PiSCSI/piscsi-hw/README.md

# piscsi-hw
Hardware Repository for PiSCSI
