PiSCSI/piscsi-hw/ctrl_board_v1p6/PCA9554APW_118/PCA9554APW_118.step

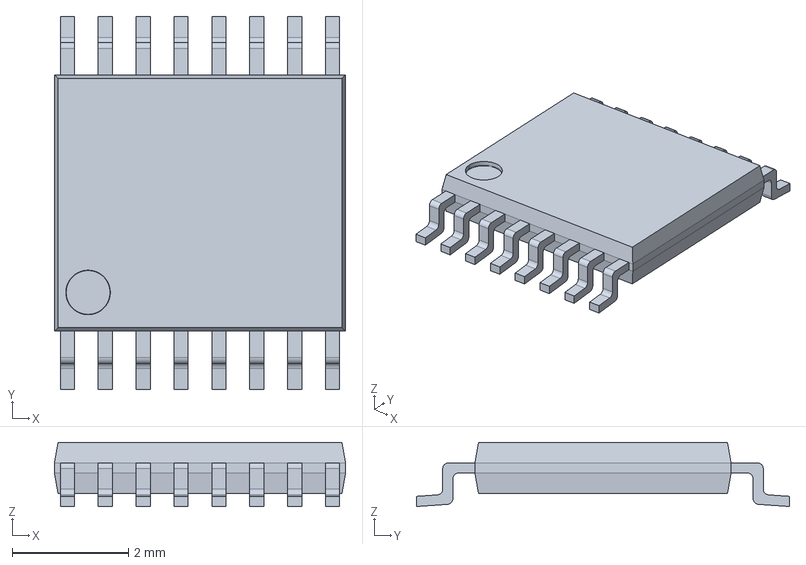
[picture p1: CAD file, 2022-11-30]
ctrl_board_v1p6/PCA9554APW_118/PCA9554APW_118.step
5.00 x 6.41 x 1.10 mm
