PiSCSI/piscsi-hw/IIciCase/IIciCase.FCStd

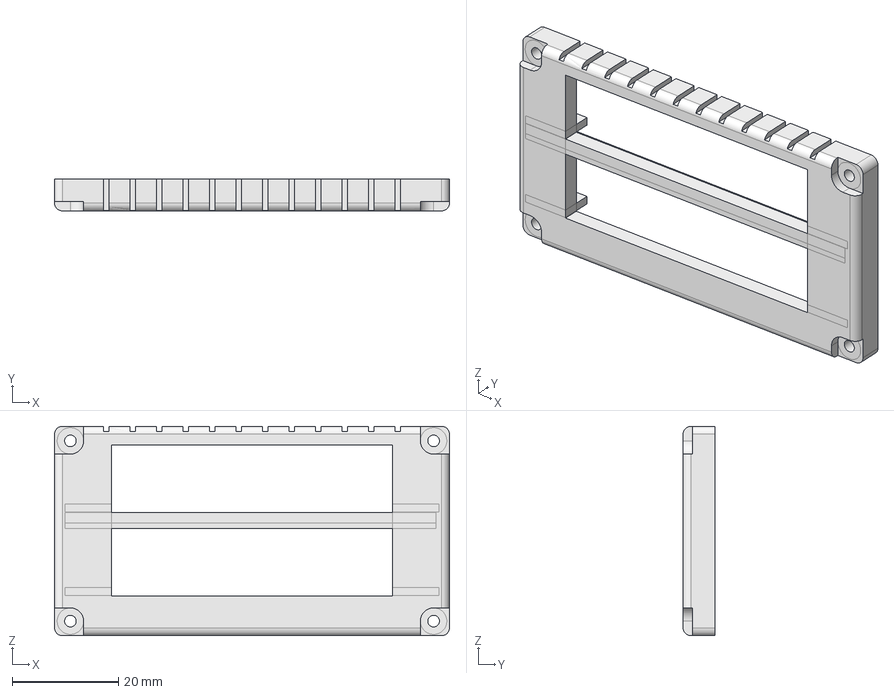
[picture p2: CAD file, 2022-11-30]
IIciCase/IIciCase.FCStd
74.5 x 6.00 x 39.5 mm
