PiSCSI/piscsi-hw/pb_bracket/powerbook_bracket.step

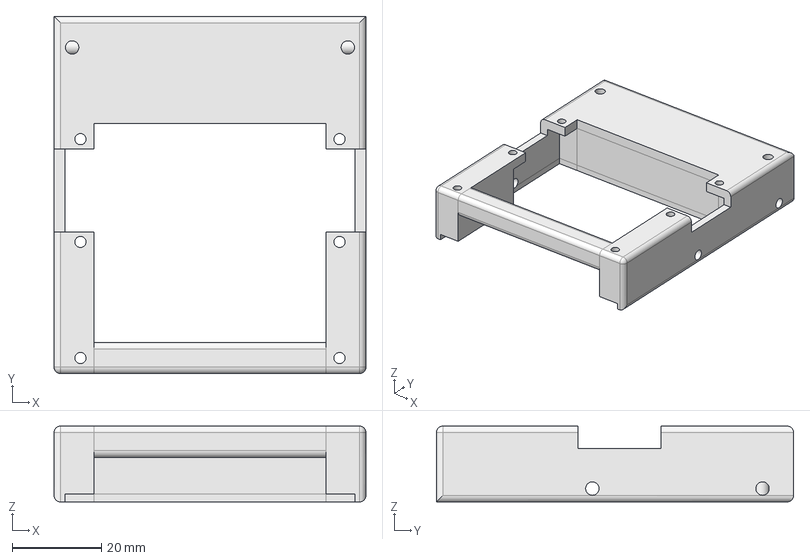
[picture p3: CAD file, 2022-11-30]
pb_bracket/powerbook_bracket.step
69.8 x 80.0 x 17.0 mm
