PiSCSI/piscsi-hw/piscsi_zero_1p1/TYPE-C-31-M-17/type-c-31-m-17.FCStd

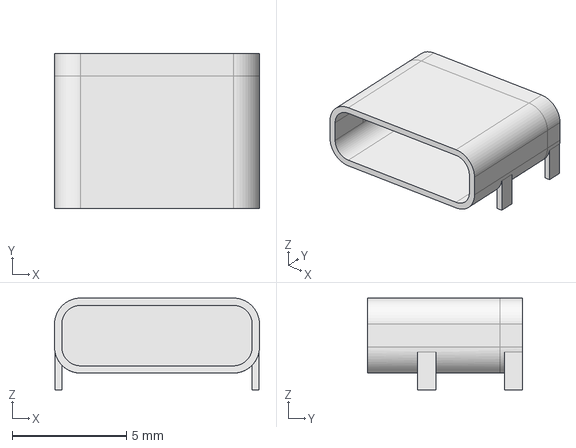
[picture p4: CAD file, 2022-11-30]
piscsi_zero_1p1/TYPE-C-31-M-17/type-c-31-m-17.FCStd
8.98 x 6.80 x 4.02 mm
