PiSCSI/piscsi-hw/rascsi_2p4/rascsi_2p4.step

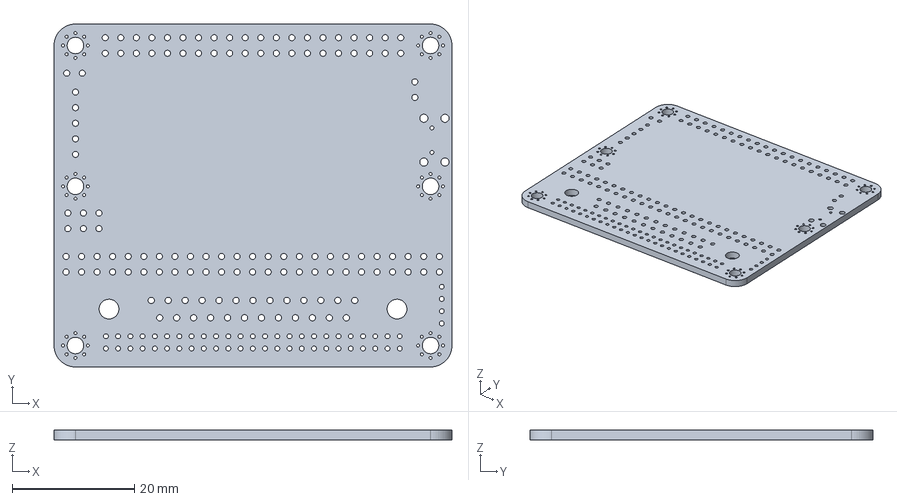
[picture p5: CAD file, 2022-11-30]
rascsi_2p4/rascsi_2p4.step
65.0 x 56.0 x 1.60 mm
