PiSCSI/piscsi-hw/rascsi_pogo_holder/rascsi_pogo_holder.FCStd

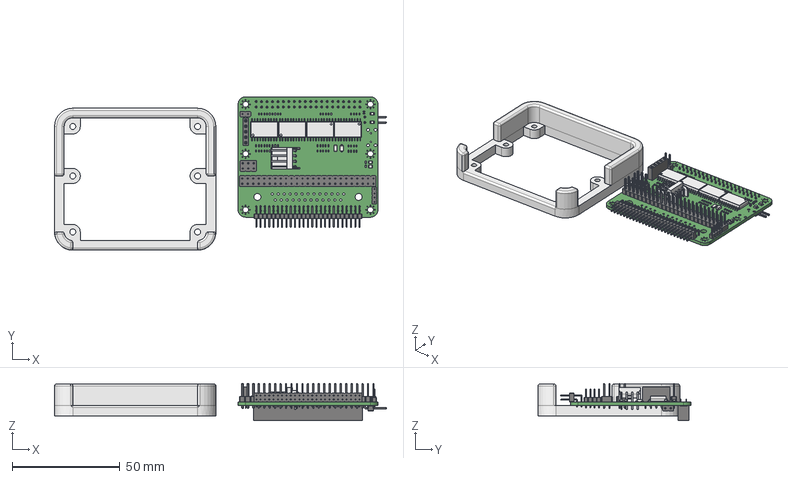
[picture p6: CAD file, 2022-11-30]
rascsi_pogo_holder/rascsi_pogo_holder.FCStd
154.3 x 71.3 x 17.2 mm
RaSCSI Holder
