PiSCSI/piscsi-hw/(list of files, cad)

Other CAD files:
rascsi_2p5/rascsi_2p5.step
piscsi_zero_1p1/TYPE-C-31-M-17/type-c-31-m-17-Body.step
pb_bracket/powerbook_bracket.FCStd
pb_bracket/powerbook_bracket.stl
rascsi_pogo_holder/rascsi_pogo_holder.stl
