PiSCSI/piscsi-hw/(threads)

Thread 7 (2024-04-23):

pizero 1.1 files are not correct in the JCLPCB section

Biker1bob, 2024-04-23:
The files cannot be produced @ JCLPCB.  Footprint of a couple of parts is not correct.

Also an accurate BOM and P&P file are not present.

Do it myself but I am not confident of my skills for that to post it up for all to use.
