PiSCSI/piscsi-hw/piscsi_zero_1p1/rascsi_zero_sch.pdf

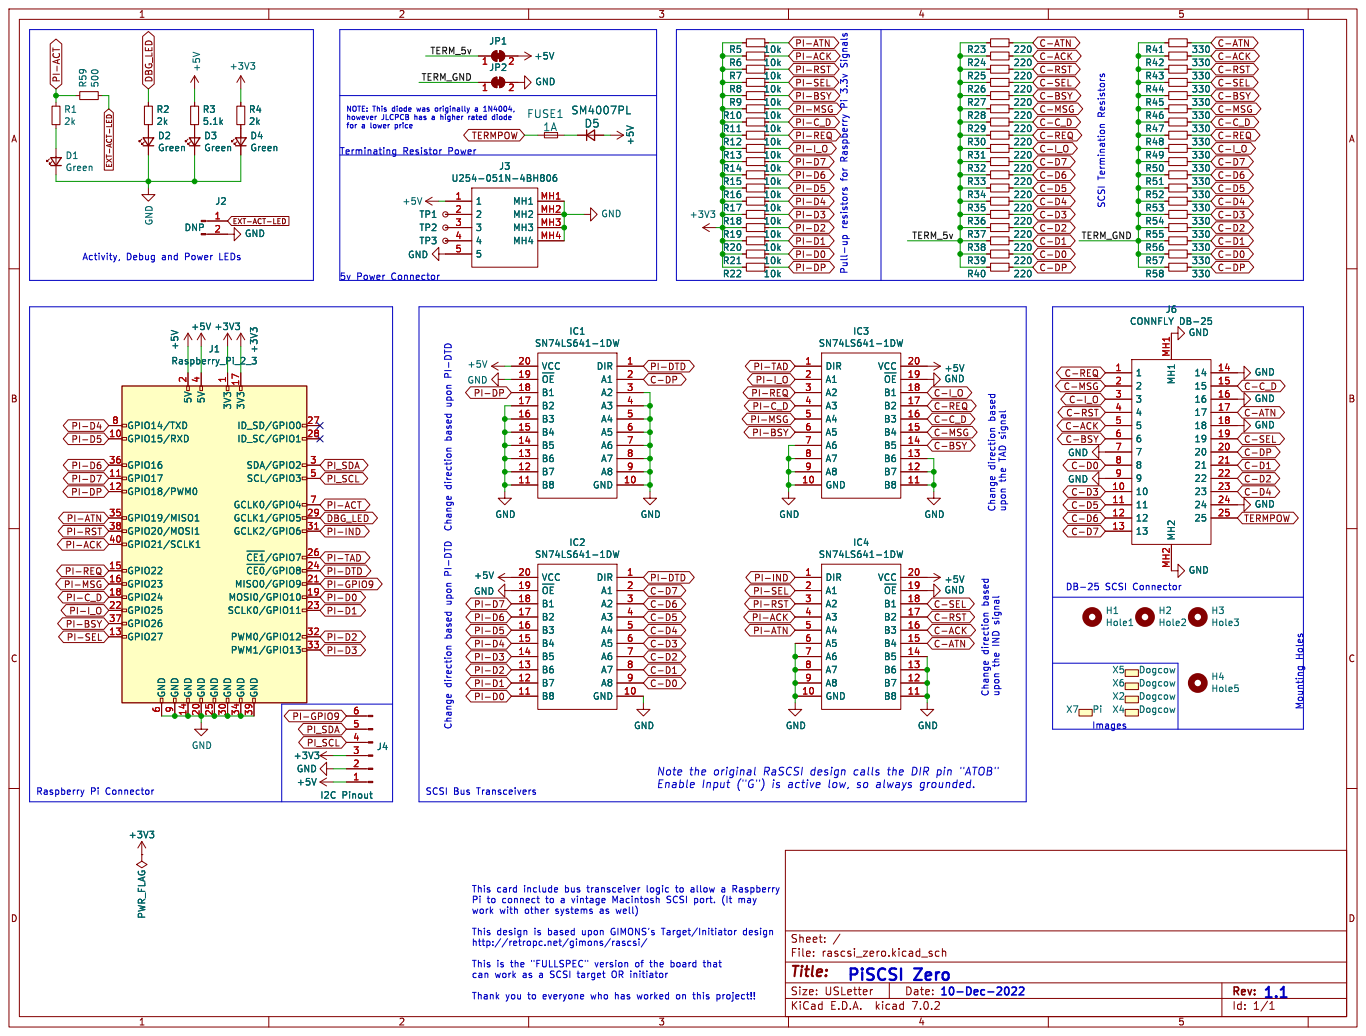
[picture p7: page 1]

C-ACK C-BSY C-D0 PI-D6 PI-D4 PI-D7 PI-D5 PI-D0 PI-D2 PI-D1 PI-D3 TERMPOW

PI-ATN
PI-SEL PI-ACK
PI-RST PI-BSY

C-SEL C-RST C-ACK PI-D2 PI-D1 PI-D3 PI-D0 PI-GPIO9 EXT-ACT-LED

EXT-ACT-LED PI-C_D

1 GPIO15/RXD 10 GPIO17 11 GPIO18/PWM0 12 GPIO27 13 GND 14 GPIO22 15 GPIO23 16 3V3 17 GPIO24 18 MOSI0/GPIO10 19 5V
PI-SEL PI-D7 PI-D4 PI-D5 PI-D6 PI-DP

PI-RST PI-ACK

Id: 1/1 Title: File: rascsi_zero.kicad_sch Sheet: /
