PiSCSI/piscsi-hw/piscsi_2p7/piscsi_sch.pdf

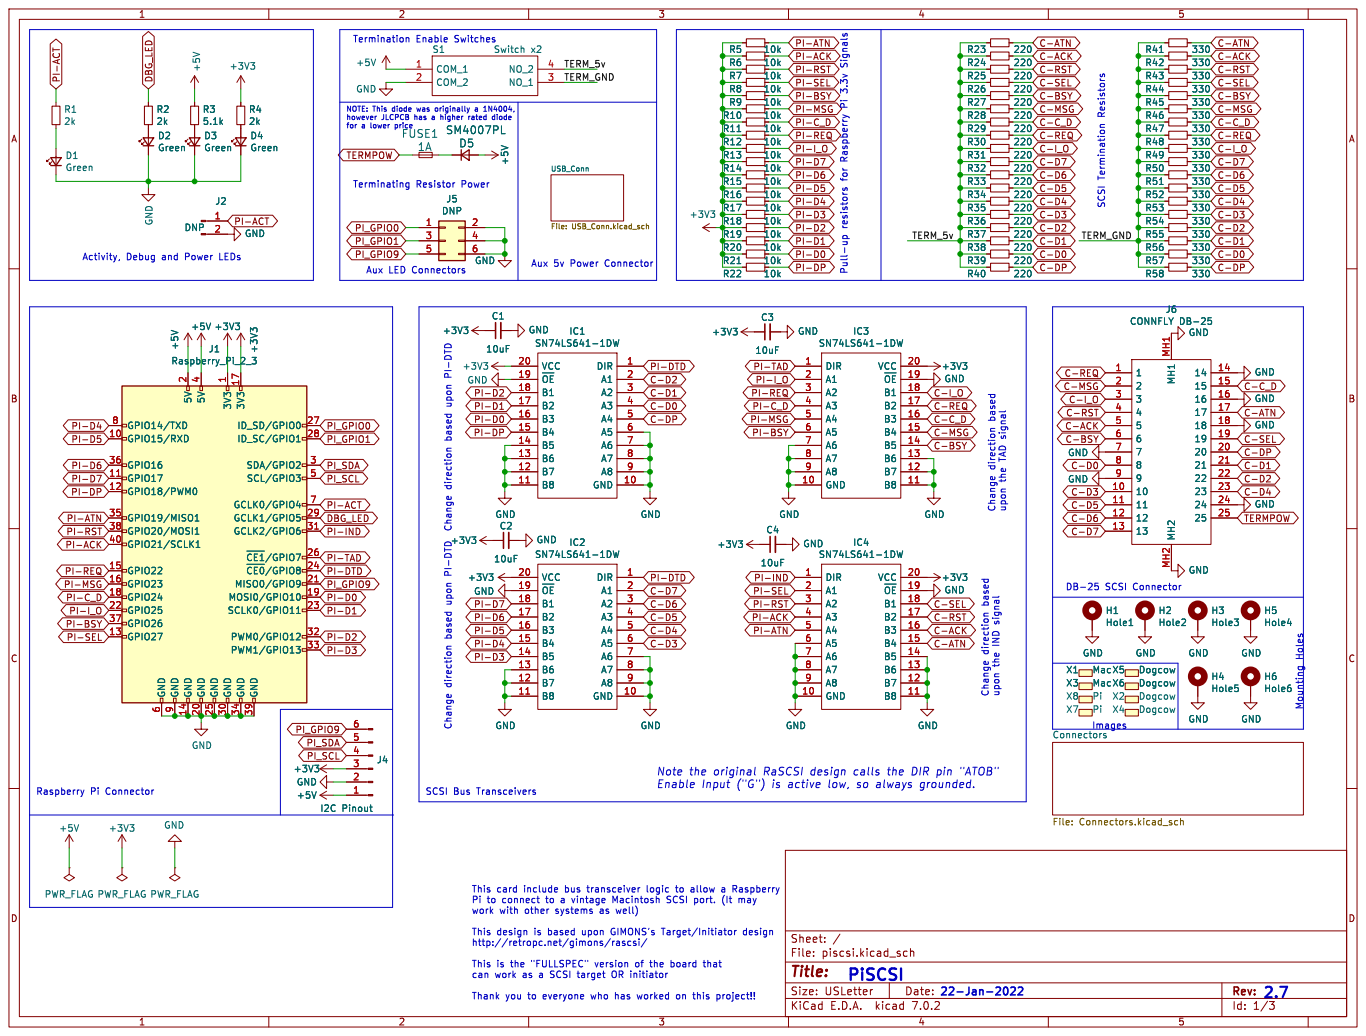
[picture p8: page 1]

PI-ACK
PI-RST PI-SEL PI-MSG
C-SEL PI-D3 PI-D7 PI-D1 PI-D0 PI-D2 PI-D5 PI-D4 PI-D6 PI-REQ

C-SEL PI-ACT PI-TAD

Aux LED ConnectorsChange direction based upon PI-DTD

Aux 5v Power Connector Change direction based upon PI-DTD
GND

PI-RST PI-REQ

PI-RST PI-IND
PI-SEL PI-ATN

E.D.A. kicad 7.0.2 Size: USLetter Rev: | D Date: KiCad

http://retropc.net/gimons/rascsi/ This is the "FULLSPEC" version of the board that can work as a SCSI target OR initiator Thank you to everyone who has worked on this project!!

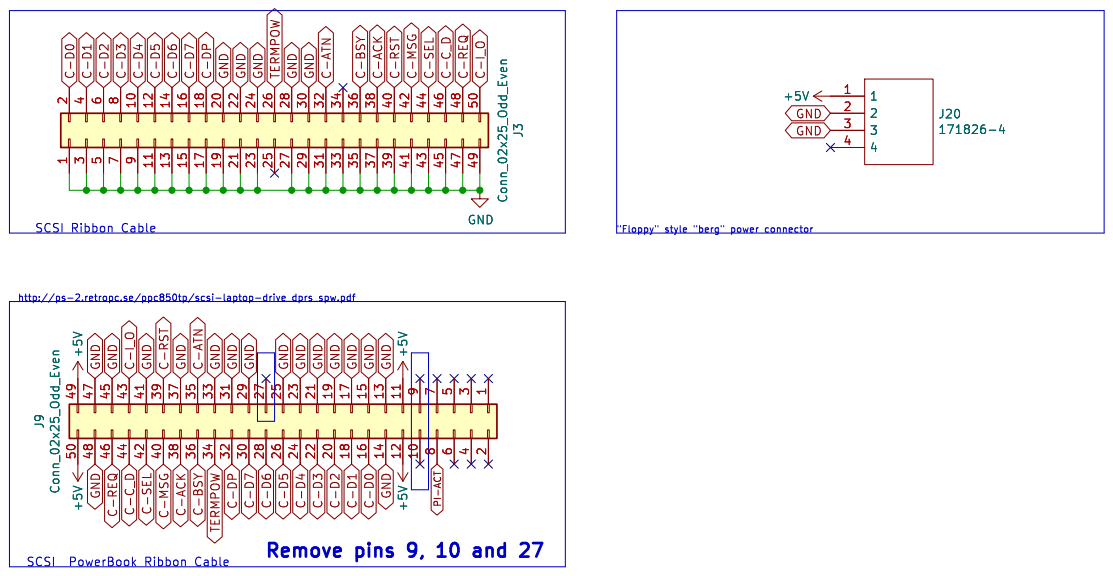
[picture p9: page 2]

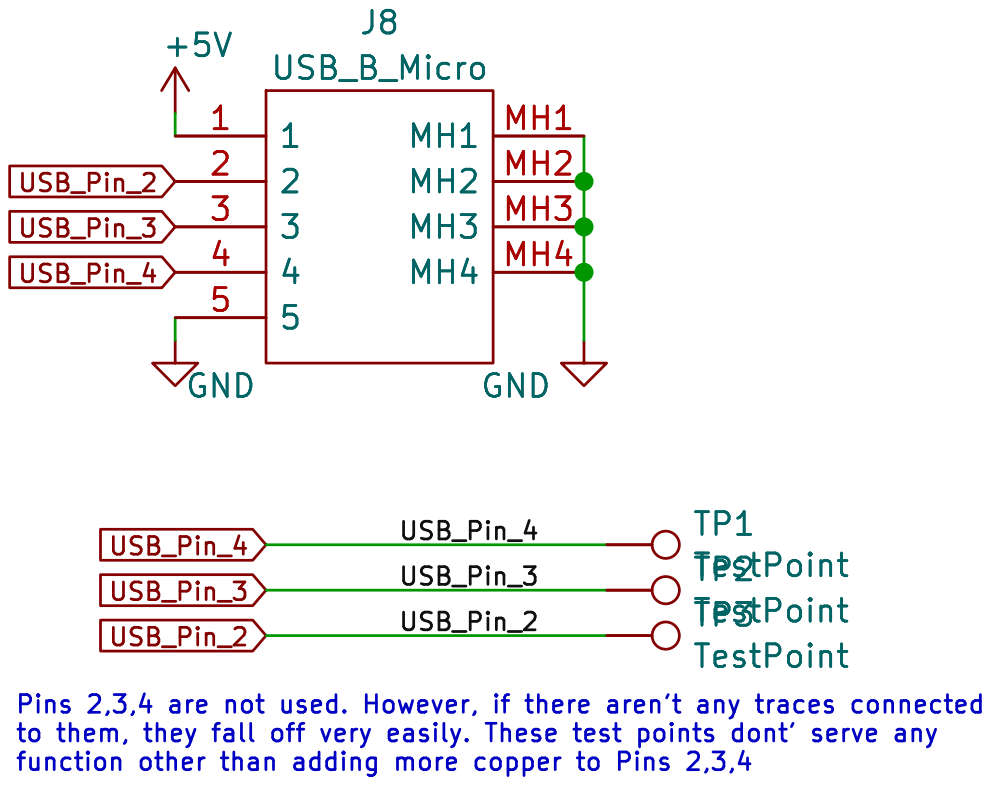
[picture p10: page 3]

to them, they fall off very easily. These test points dont' serve any

Id: 3/3 Title: File: USB_Conn.kicad_sch Sheet: /USB_Conn/
