PiSCSI/piscsi-hw/daisy_chain_board_v2/daisy_chain_board_sch.pdf

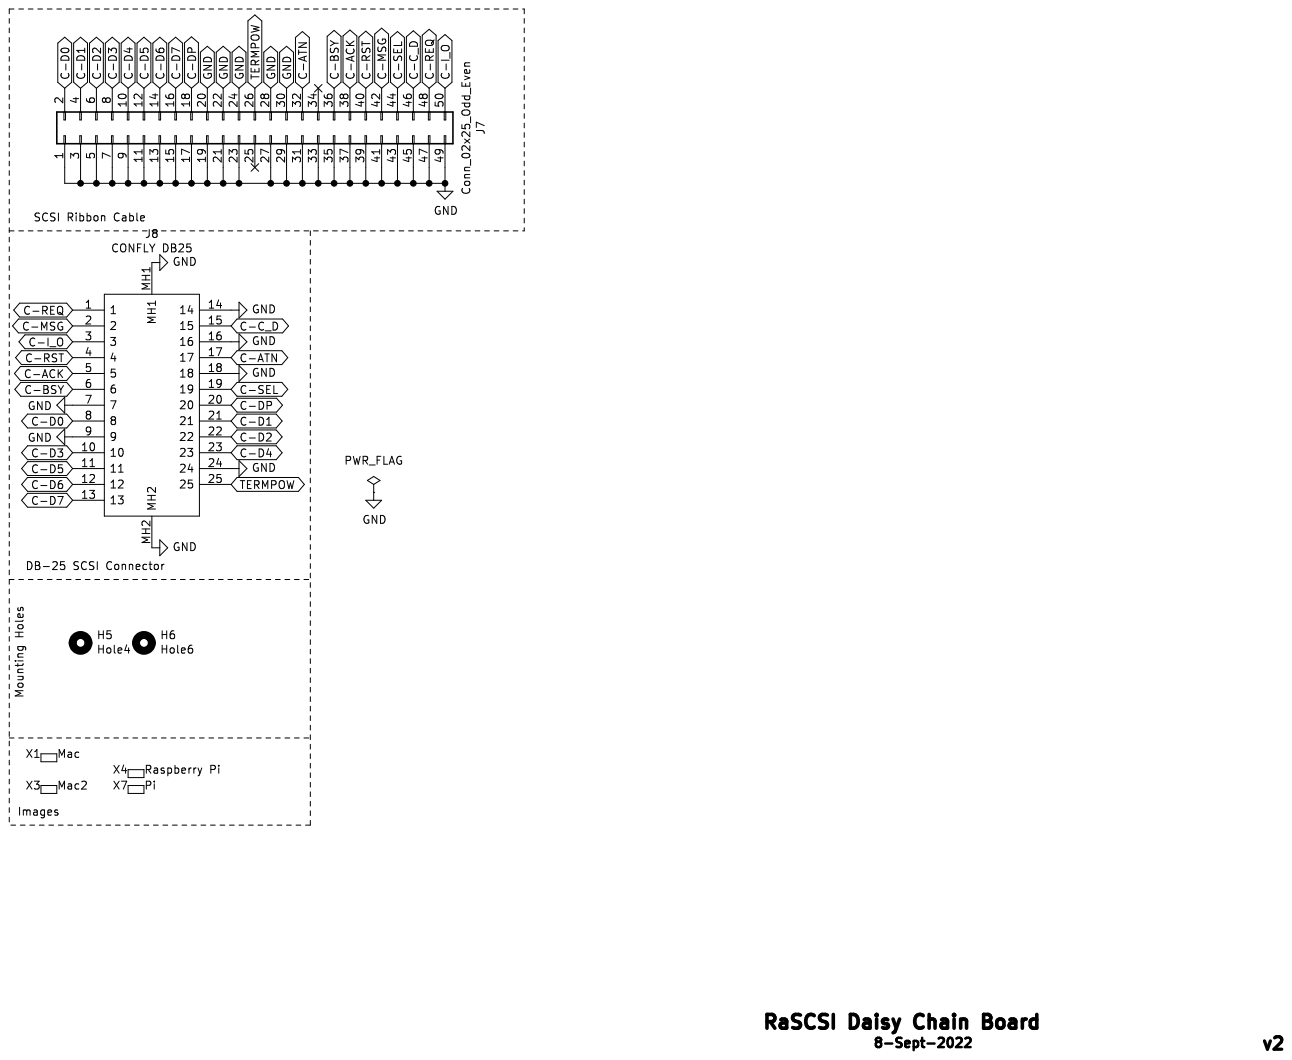
[picture p14: page 1]
