PiSCSI/piscsi-hw/rascsi_2p6/rascsi_2p6_sch.pdf

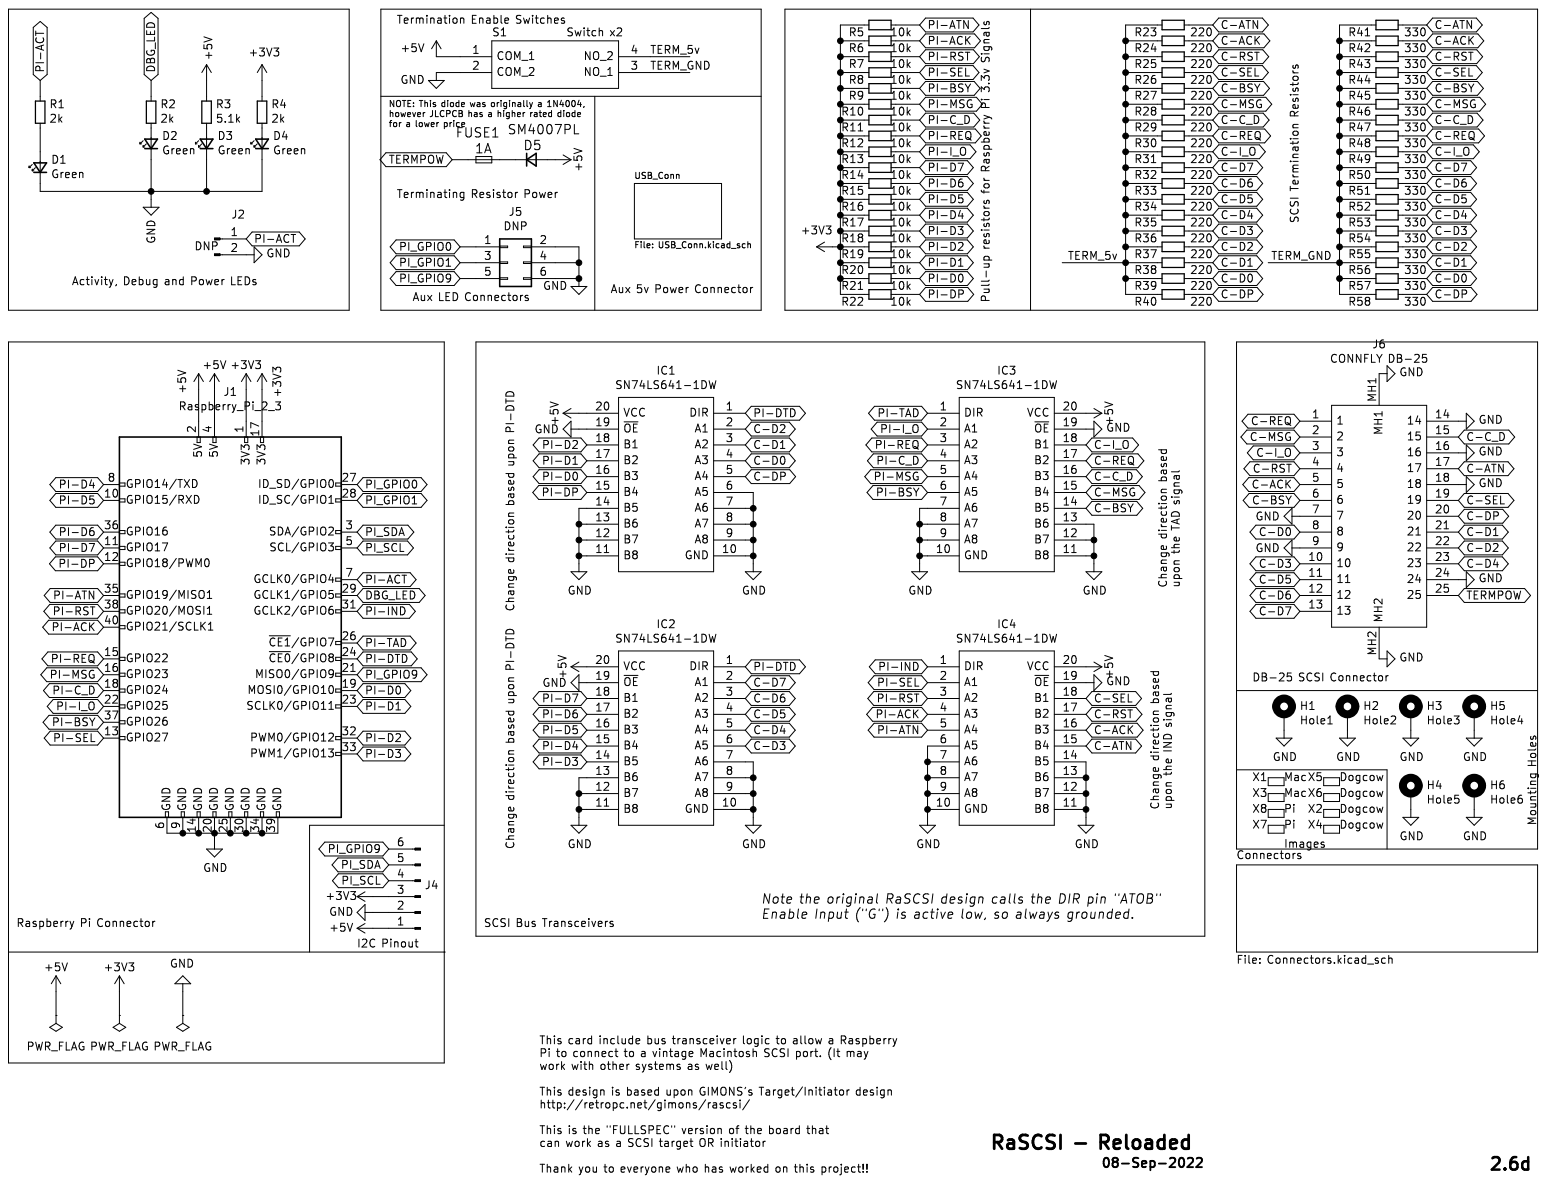
[picture p15: page 1]

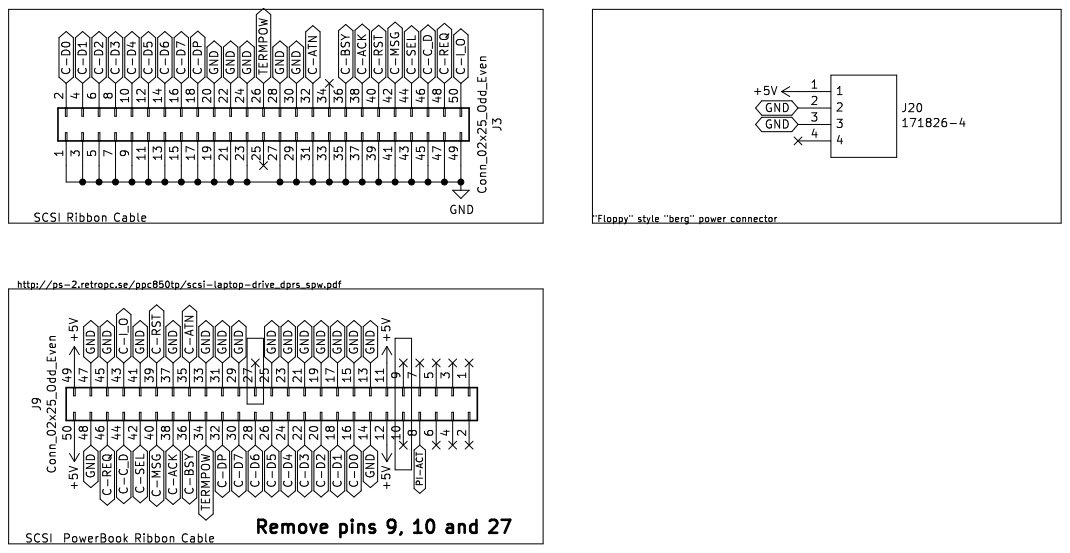
[picture p16: page 2]

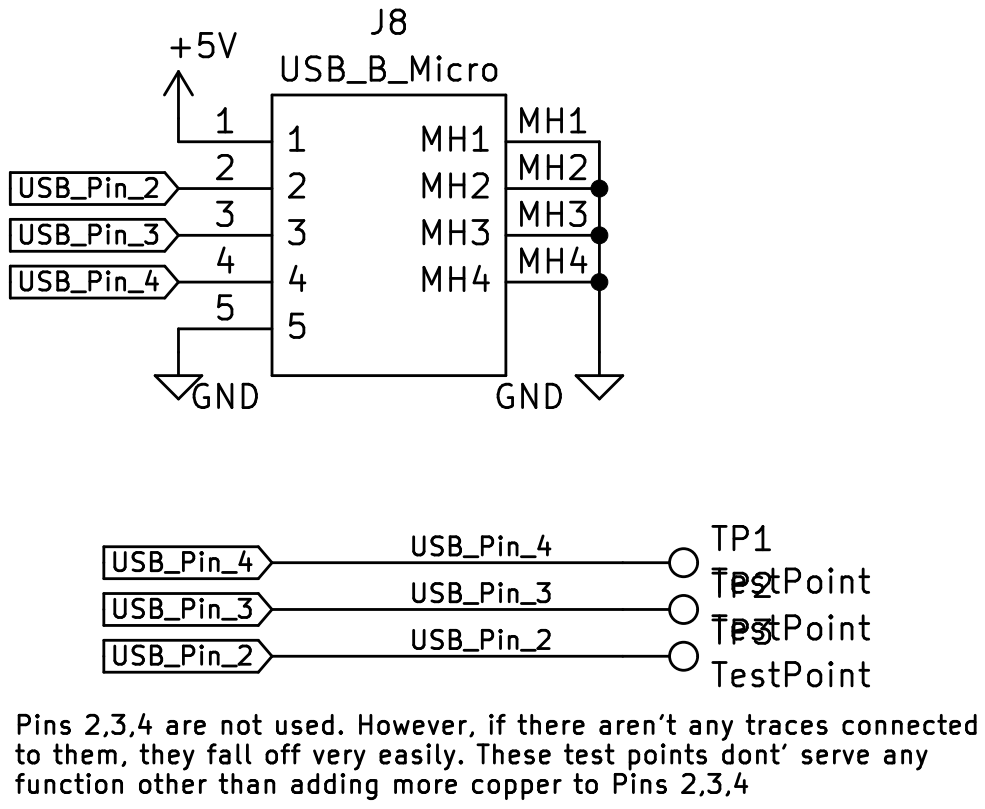
[picture p17: page 3]
