PiSCSI/piscsi-hw/piscsi_zero_1p1/rascsi_zero.kicad_pcb

## KiCad design piscsi_zero_1p1/rascsi_zero.kicad_pcb (2023-02-27)

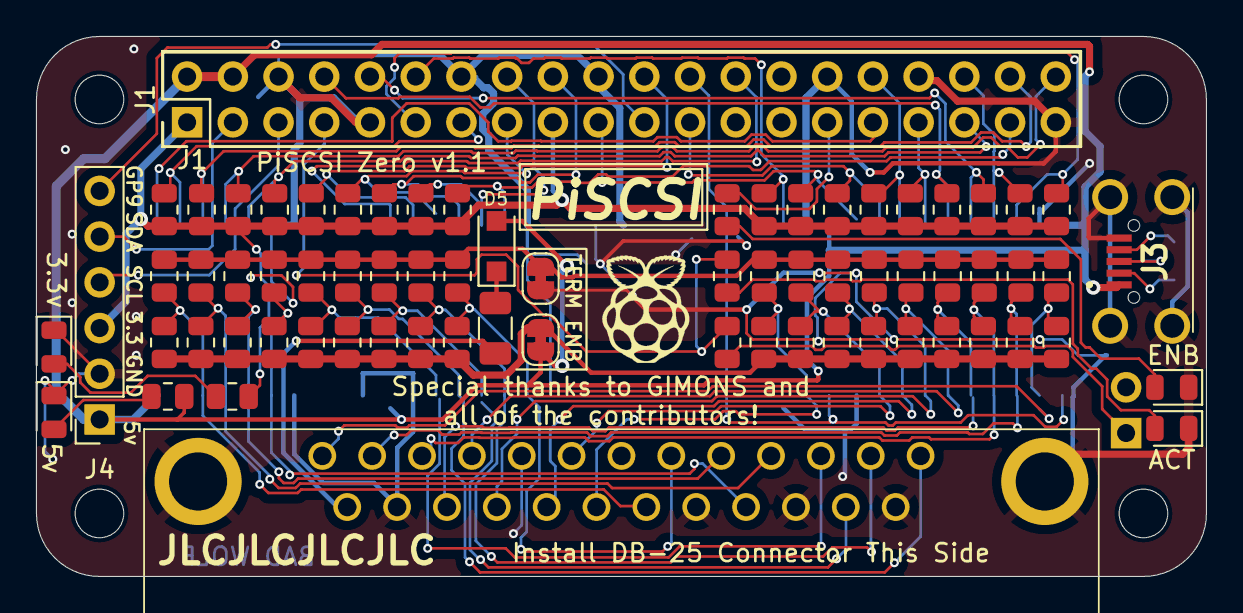
[picture p21: board rascsi_zero.kicad_pcb from above]

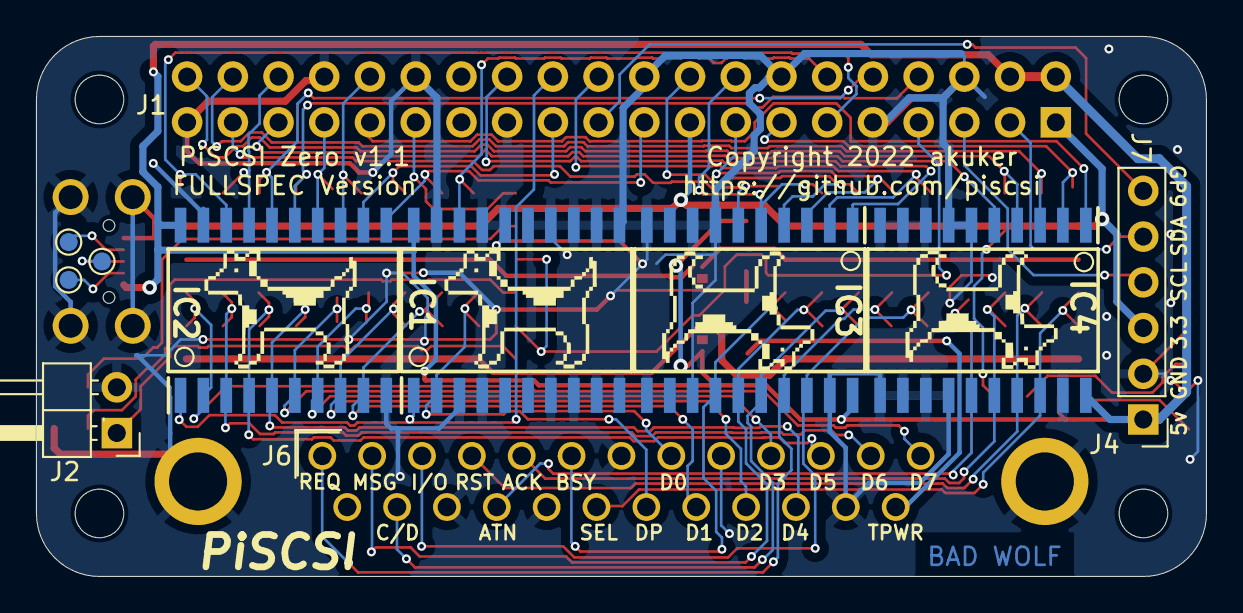
[picture p22: board rascsi_zero.kicad_pcb from below]

Board: 2 copper layers, 65.0 x 30.0 mm, 88 parts (13 on the bottom side), 59 nets.

Parts:
D1, D2, D3, D4: Green; LED_0805_2012Metric
D5: SM4007PL; D_SOD-123F
FUSE1: 1A; Fuse_1206_3216Metric
H1: Hole1; MountingHole_2.7mm_M2.5
H2: Hole2; MountingHole_2.7mm_M2.5
H3: Hole3; MountingHole_2.7mm_M2.5
H4: Hole5; MountingHole_2.7mm_M2.5
IC1, IC2, IC3, IC4: SN74LS641-1DW; SOIC127P1030X265-20N
J1: Raspberry_Pi_2_3; PinHeader_2x20_P2.54mm_Vertical
J2: DNP; PinHeader_1x02_P2.54mm_Horizontal
J3: U254-051N-4BH806; U254051N4BH806
J4: I2C Pinout; PinSocket_1x06_P2.54mm_Vertical
J6: CONNFLY DB-25; L717SDB25PA4CH4F
JP1, JP2: SolderJumper_2_Bridged; SolderJumper-2_P1.3mm_Bridged_RoundedPad1.0x1.5mm
R1, R2, R4: 2k; R_0805_2012Metric
R3: 5.1k; R_0805_2012Metric
R5, R6, R7, R8, R9, R10, R11, R12, R13, R14, R15, R16, R17, R18, R19, R20, R21, R22: 10k; R_0805_2012Metric
R23, R24, R25, R26, R27, R28, R29, R30, R31, R32, R33, R34, R35, R36, R37, R38, R39, R40: 220; R_0805_2012Metric
R41, R42, R43, R44, R45, R46, R47, R48, R49, R50, R51, R52, R53, R54, R55, R56, R57, R58: 330; R_0805_2012Metric
R59: 500; R_0805_2012Metric
TP1, TP2, TP3: TestPoint_Small; TestPoint_Pad_D1.0mm
X2, X4, X5, X6: Dogcow; dogcow
X7: Pi; pi_logo

Connections:
+3V3: J1.1 (3V3), J1.17 (3V3), J4.3, R4.1, R5.1, R6.1, R7.1, R8.1, R9.1, R10.1, R11.1, R12.1, R13.1, R14.1, R15.1, R16.1, R17.1, R18.1, R19.1, R20.1, R21.1, R22.1
+5V: D5.2 (A), IC1.20 (VCC), IC2.20 (VCC), IC3.20 (VCC), IC4.20 (VCC), J1.2 (5V), J1.4 (5V), J3.1, J4.1, JP1.2 (B), R3.1
/TERM_5v: JP1.1 (A), R23.1, R24.1, R25.1, R26.1, R27.1, R28.1, R29.1, R30.1, R31.1, R32.1, R33.1, R34.1, R35.1, R36.1, R37.1, R38.1, R39.1, R40.1
/TERM_GND: JP2.1 (A), R41.1, R42.1, R43.1, R44.1, R45.1, R46.1, R47.1, R48.1, R49.1, R50.1, R51.1, R52.1, R53.1, R54.1, R55.1, R56.1, R57.1, R58.1
C-ACK: IC4.16 (B3), J6.5, R24.2, R42.2
C-ATN: IC4.15 (B4), J6.17, R23.2, R41.2
C-BSY: IC3.14 (B5), J6.6, R27.2, R45.2
C-C_D: IC3.16 (B3), J6.15, R29.2, R47.2
C-D0: IC2.9 (A8), J6.8, R39.2, R57.2
C-D1: IC2.8 (A7), J6.21, R38.2, R56.2
C-D2: IC2.7 (A6), J6.22, R37.2, R55.2
C-D3: IC2.6 (A5), J6.10, R36.2, R54.2
C-D4: IC2.5 (A4), J6.23, R35.2, R53.2
C-D5: IC2.4 (A3), J6.11, R34.2, R52.2
C-D6: IC2.3 (A2), J6.12, R33.2, R51.2
C-D7: IC2.2 (A1), J6.13, R32.2, R50.2
C-DP: IC1.2 (A1), J6.20, R40.2, R58.2
C-I_O: IC3.18 (B1), J6.3, R31.2, R49.2
C-MSG: IC3.15 (B4), J6.2, R28.2, R46.2
C-REQ: IC3.17 (B2), J6.1, R30.2, R48.2
C-RST: IC4.17 (B2), J6.4, R25.2, R43.2
C-SEL: IC4.18 (B1), J6.19, R26.2, R44.2
DBG_LED: J1.29 (GCLK1/GPIO5), R2.1
EXT-ACT-LED: J2.1, R59.2
GND: D1.1 (K), D2.1 (K), D3.1 (K), D4.1 (K), IC1.3 (A2), IC1.4 (A3), IC1.5 (A4), IC1.6 (A5), IC1.7 (A6), IC1.8 (A7), IC1.9 (A8), IC1.10 (GND), IC1.11 (B8), IC1.12 (B7), IC1.13 (B6), IC1.14 (B5), IC1.15 (B4), IC1.16 (B3), IC1.17 (B2), IC1.19 (~OE), IC2.10 (GND), IC2.19 (~OE), IC3.7 (A6), IC3.8 (A7), IC3.9 (A8), IC3.10 (GND), IC3.11 (B8), IC3.12 (B7), IC3.13 (B6), IC3.19 (~OE), IC4.6 (A5), IC4.7 (A6), IC4.8 (A7), IC4.9 (A8), IC4.10 (GND), IC4.11 (B8), IC4.12 (B7), IC4.13 (B6), IC4.14 (B5), IC4.19 (~OE), J1.6 (GND), J1.9 (GND), J1.14 (GND), J1.20 (GND), J1.25 (GND), J1.30 (GND), J1.34 (GND), J1.39 (GND), J2.2, J3.5, J3.MH1, J3.MH2, J3.MH3, J3.MH4, J4.2, J6.7, J6.9, J6.14, J6.16, J6.18, J6.24, J6.MH1, J6.MH2, JP2.2 (B)
unnamed: D1.2 (A), R1.2
unnamed: D2.2 (A), R2.2
unnamed: D3.2 (A), R3.2
unnamed: D4.2 (A), R4.2
unnamed: D5.1 (K), FUSE1.1
unnamed: J3.2, TP1.1
unnamed: J3.3, TP2.1
unnamed: J3.4, TP3.1
PI-ACK: IC4.4 (A3), J1.40 (GPIO21/SCLK1), R6.2
PI-ACT: J1.7 (GCLK0/GPIO4), R1.1, R59.1
PI-ATN: IC4.5 (A4), J1.35 (GPIO19/MISO1), R5.2
PI-BSY: IC3.6 (A5), J1.37 (GPIO26), R9.2
PI-C_D: IC3.4 (A3), J1.18 (GPIO24), R11.2
PI-D0: IC2.11 (B8), J1.19 (MOSI0/GPIO10), R21.2
PI-D1: IC2.12 (B7), J1.23 (SCLK0/GPIO11), R20.2
PI-D2: IC2.13 (B6), J1.32 (PWM0/GPIO12), R19.2
PI-D3: IC2.14 (B5), J1.33 (PWM1/GPIO13), R18.2
PI-D4: IC2.15 (B4), J1.8 (GPIO14/TXD), R17.2
PI-D5: IC2.16 (B3), J1.10 (GPIO15/RXD), R16.2
PI-D6: IC2.17 (B2), J1.36 (GPIO16), R15.2
PI-D7: IC2.18 (B1), J1.11 (GPIO17), R14.2
PI-DP: IC1.18 (B1), J1.12 (GPIO18/PWM0), R22.2
PI-DTD: IC1.1 (DIR), IC2.1 (DIR), J1.24 (~CE0/GPIO8)
PI-GPIO9: J1.21 (MISO0/GPIO9), J4.6
PI-IND: IC4.1 (DIR), J1.31 (GCLK2/GPIO6)
PI-I_O: IC3.2 (A1), J1.22 (GPIO25), R13.2
PI-MSG: IC3.5 (A4), J1.16 (GPIO23), R10.2
PI-REQ: IC3.3 (A2), J1.15 (GPIO22), R12.2
PI-RST: IC4.3 (A2), J1.38 (GPIO20/MOSI1), R7.2
PI-SEL: IC4.2 (A1), J1.13 (GPIO27), R8.2
PI-TAD: IC3.1 (DIR), J1.26 (~CE1/GPIO7)
PI_SCL: J1.5 (SCL/GPIO3), J4.4
PI_SDA: J1.3 (SDA/GPIO2), J4.5
TERMPOW: FUSE1.2, J6.25
