PiSCSI/piscsi-hw/loopback_tester/loopback_tester.kicad_pcb

## KiCad design loopback_tester/loopback_tester.kicad_pcb (2022-11-30)

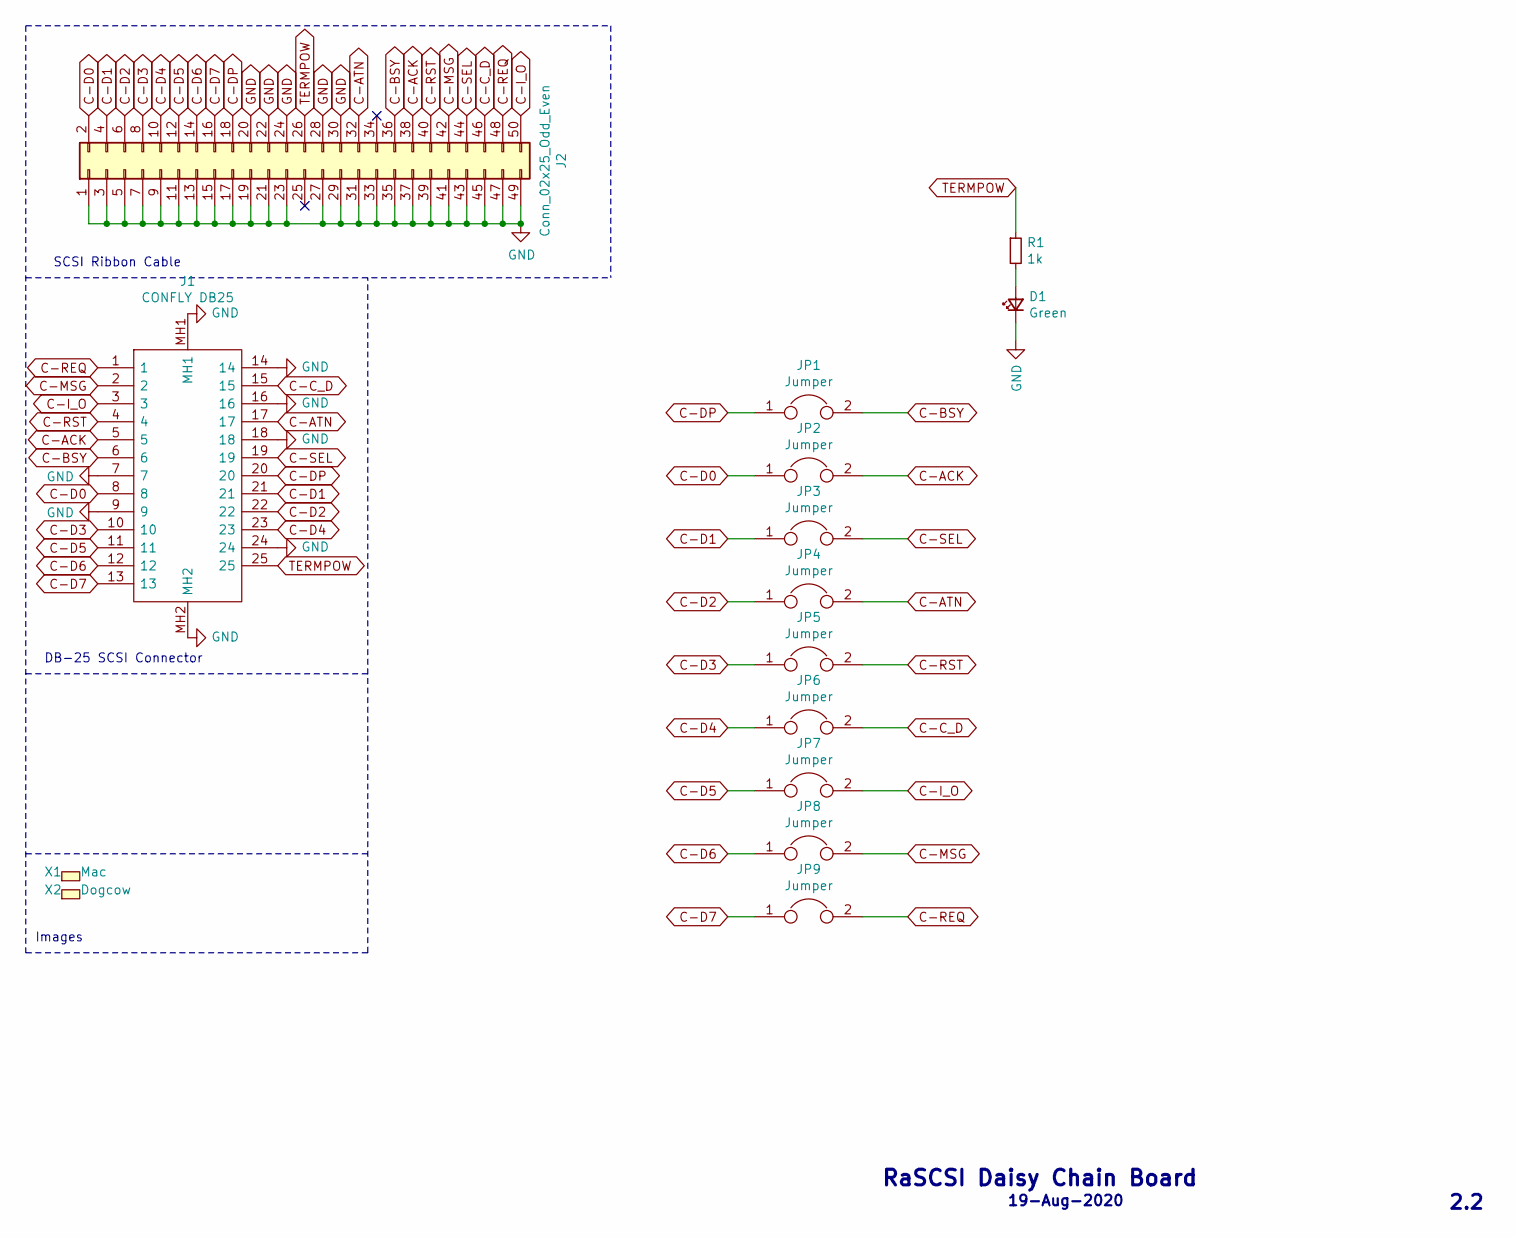
[picture p28: schematic loopback_tester.sch]

Parts:
D1: Green; LED_0805_2012Metric; LCSC C2297
J1: CONFLY DB25; L717SDB25PA4CH4F; Mouser Part Number 523-L717SDB25PA4CH4F
J2: Conn_02x25_Odd_Even; PinSocket_2x25_P2.54mm_Vertical; LCSC C40024
JP1, JP2, JP3, JP4, JP5, JP6, JP7, JP8, JP9: Jumper; SolderJumper-2_P1.3mm_Bridged_RoundedPad1.0x1.5mm
R1: 1k; R_0805_2012Metric; LCSC C17513
X1: Mac; mac_happy_small
X2: Dogcow; dogcow

Connections:
C-ACK: J1.5, J2.38, JP2.2
C-ATN: J1.17, J2.32, JP4.2
C-BSY: J1.6, J2.36, JP1.2
C-C_D: J1.15, J2.46, JP6.2
C-D0: J1.8, J2.2, JP2.1
C-D1: J1.21, J2.4, JP3.1
C-D2: J1.22, J2.6, JP4.1
C-D3: J1.10, J2.8, JP5.1
C-D4: J1.23, J2.10, JP6.1
C-D5: J1.11, J2.12, JP7.1
C-D6: J1.12, J2.14, JP8.1
C-D7: J1.13, J2.16, JP9.1
C-DP: J1.20, J2.18, JP1.1
C-I_O: J1.3, J2.50, JP7.2
C-MSG: J1.2, J2.42, JP8.2
C-REQ: J1.1, J2.48, JP9.2
C-RST: J1.4, J2.40, JP5.2
C-SEL: J1.19, J2.44, JP3.2
GND: D1.1 (K), J1.7, J1.9, J1.14, J1.16, J1.18, J1.24, J1.MH1, J1.MH2, J2.1, J2.3, J2.5, J2.7, J2.9, J2.11, J2.13, J2.15, J2.17, J2.19, J2.20, J2.21, J2.22, J2.23, J2.24, J2.27, J2.28, J2.29, J2.30, J2.31, J2.33, J2.35, J2.37, J2.39, J2.41, J2.43, J2.45, J2.47, J2.49
unnamed: D1.2 (A), R1.2
TERMPOW: J1.25, J2.26, R1.1

Notes on the sheet:
DB-25 SCSI Connector
SCSI Ribbon Cable
Images
RaSCSI Daisy Chain Board
2.2
19-Aug-2020

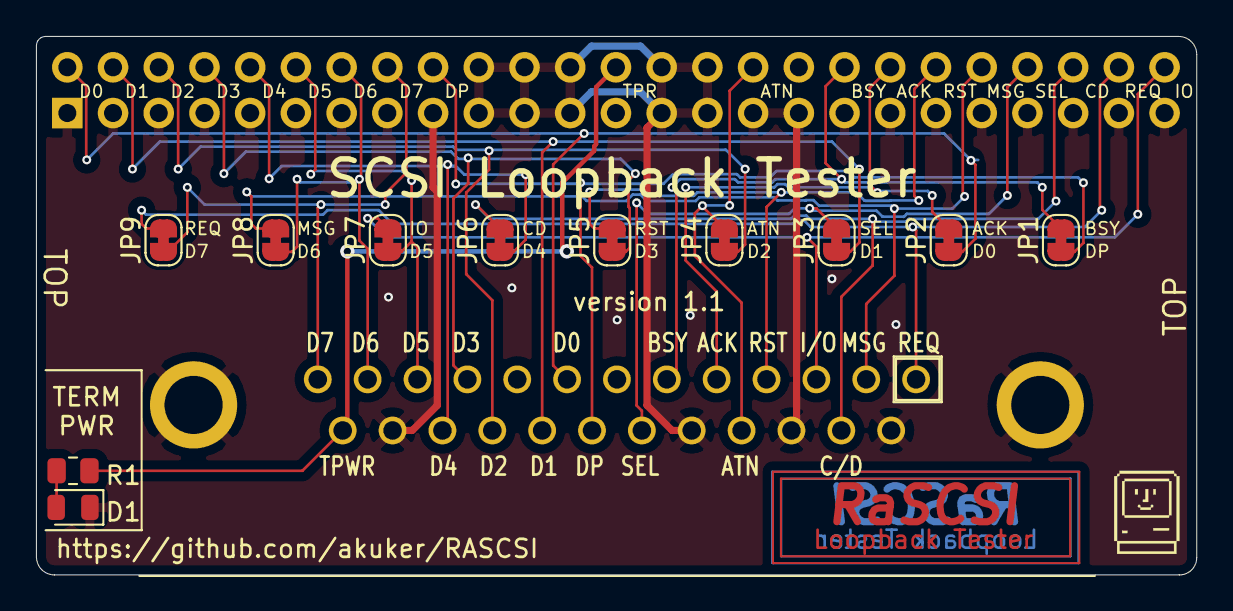
[picture p29: board loopback_tester.kicad_pcb from above]

Board: 2 copper layers, 64.5 x 29.9 mm, 15 parts (0 on the bottom side), 21 nets.
