PiSCSI/piscsi-hw/(commit log)

2020-07-10 Commit version 1.5 of the RASCSI board from https://github.com/akuker/RASCSI-68kmlaver
    [rascsi_din-B_Mask.gbr, rascsi_din-B_Paste.gbr, rascsi_din-B_SilkS.gbr, rascsi_din-Bottom.gbr, rascsi_din-Edge_Cuts.gbr, rascsi_din-F_Mask.gbr, rascsi_din-F_Paste.gbr, rascsi_din-F_SilkS.gbr]
2020-07-10 Opened with KiCad to fix file/library errors
2020-07-10 Commit version 1.5 schematic
2020-08-01 First draft of rascsi version 2.1
    [rascsi_2p1.kicad_pcb, rascsi_2p1.sch]
2020-08-01 Generated gerber files, part lists and re-generated schematic
    [rascsi_2p1-B_Mask.gbr, rascsi_2p1-B_Paste.gbr, rascsi_2p1-B_SilkS.gbr, rascsi_2p1-Bottom.gbr, rascsi_2p1-Edge_Cuts.gbr, rascsi_2p1-F_Mask.gbr, rascsi_2p1-F_Paste.gbr, rascsi_2p1-F_SilkS.gbr]
2020-08-02 Fixed silkscreen for tranceivers
    [rascsi_2p1.kicad_pcb]
2020-08-03 Fixed orientation of termpwr diode. Updated to version "2.1a"
    [rascsi_2p1.kicad_pcb, rascsi_2p1.sch]
2020-08-03 Regenerated BOM, footprint listing, GERBER files and Schematic
    [rascsi_2p1-B_Mask.gbr, rascsi_2p1-B_Paste.gbr, rascsi_2p1-B_SilkS.gbr, rascsi_2p1-Bottom.gbr, rascsi_2p1-Edge_Cuts.gbr, rascsi_2p1-F_Mask.gbr, rascsi_2p1-F_Paste.gbr, rascsi_2p1-F_SilkS.gbr]
2020-08-03 Changed Bus Transceivers to 74LS641-1 per discussion on 68kmla forums
    [rascsi_2p1.sch]
2020-08-08 Generate bill of materials for version 1.5
    [rascsi_din_bom.csv]
2020-08-14 Created version 1.6 with issue #10 fixed. Renamed version 1.5 to a better folder name
    [rascsi_din-B_Mask.gbr, rascsi_din-B_Paste.gbr, rascsi_din-B_SilkS.gbr, rascsi_din-Bottom.gbr, rascsi_din-Edge_Cuts.gbr, rascsi_din-F_Mask.gbr, rascsi_din-F_Paste.gbr, rascsi_din-F_SilkS.gbr]
2020-08-23 Version 2.2 of the fullspec board with surface mount parts (#24)
    * Version 2.2 of the fullspec board with surface mount parts
    * Create testing device for rascsi hardware
    * Updated daisychain board to include the TERMPWR signal
    [Test_Circuit.sch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]
2020-09-12 Proposed 2p3 version - Added RPi HAT EEPROM, fixed 3v/5v LED caption, added copper to USB port traces
    [Serial_Eeprom.sch, USB_Conn.sch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]
2020-09-22 Commit ordered version of the board
    [USB_Conn.sch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]
2020-09-22 Updated to correct part fields and descriptions. Removed conflicting mouser references
    [USB_Conn.sch, rascsi_2p3.sch, rascsi_2p3_bom_csv_grouped_by_value.csv, rascsi_2p3_jlcpcb_bom.csv]
2020-10-17 Create IIciCase.FCStd (#44)
    [IIciCase.FCStd]
2021-01-22 Added STEP file and updated symbol and 3d model references to reference the correct gender of parts. Should be no functional change
    [daisy_chain_board.kicad_pcb, daisy_chain_board.sch]
2021-01-22 Added 3D models and correct footprints for STEP file
2021-05-22 Added loopback schematic
    [loopback.kicad_pcb, loopback.sch]
2021-05-22 Remove schematic
    [loopback.kicad_pcb, loopback.sch]
2021-06-08 RaSCSI hardware version 2.4 (#94)
    * First attempt at adding 2.5 inch drive connector
    * Clean up silkscreen and fix DRC issues
    * additional cleanup. Made Pin 1 of the PB connector square
    * minor tweaks
    * Updates for ordered version
    * Generate step file and schematic pdf
    * First draft of powerbook drive bracket
    * Added side holes and hole for MIPI connector
    * Additional updates to the powerbook 3d printed bracket
    * Moved RaSCSI board 1mm in + lots of cleanup
    * Added optional floppy power connector. As-ordered version 2.4a
    * Added optional floppy power connector. As-ordered version 2.4a
    [Connectors.sch, Serial_Eeprom.sch, USB_Conn.sch, powerbook_bracket.FCStd, powerbook_bracket.step, powerbook_bracket.stl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]
2021-06-09 Merge Hw 2p4 to develop (#109)
    * Generated .STEP file for RaSCSI
    * Added STEP file and updated symbol and 3d model references to reference the correct gender of parts. Should be no functional change
    * Added STEP file and updated symbol and 3d model references to reference the correct gender of parts. Should be no functional change
    * Added 3D models and correct footprints for STEP file
    * Merge version 20.12.0 into the master branch (#75)
    * Update README.md
    Added refe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
    [Connectors.sch, Serial_Eeprom.sch, USB_Conn.sch, daisy_chain_board.kicad_pcb, daisy_chain_board.sch, powerbook_bracket.FCStd, powerbook_bracket.step, powerbook_bracket.stl]
2021-11-14 Fix daisychain board files (#462)
    * Revert "Added STEP file and updated symbol and 3d model references to reference the correct gender of parts. Should be no functional change"
    This reverts commit 479cc578b885d9d675a35aab40d5217a447c2dfc.
    * Delete rascsi_tester that didn't work
    [Test_Circuit.sch, daisy_chain_board.kicad_pcb, daisy_chain_board.sch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]
2021-12-20 RaSCSI Zero version 1.0 (#546)
    [Connectors.sch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]
2021-12-20 Loopback tester pcb (#545)
    [loopback_tester-B_Mask.gbr, loopback_tester-B_SilkS.gbr, loopback_tester-Bottom.gbr, loopback_tester-Edge_Cuts.gbr, loopback_tester-F_Mask.gbr, loopback_tester-F_SilkS.gbr, loopback_tester-NPTH.drl, loopback_tester-PTH.drl]
2022-01-17 Generate PDF of schematic (#615)
2022-03-03 Hardware Version 2.5 (#720)
    * Added header for external ENB LED
    * test fixture for rascsi
    * test fixture for rascsi
    * Updated to Kicad 6 and modified act LED
    * Regenerated Gerber files to fix drill placement. Added CE logo
    * Regeneraged gerbers
    [Connectors.kicad_sch, USB_Conn.kicad_sch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]
2022-03-03 Control board for managing the RaSCSI configuration (#721)
    * First draft of control board - Issue #382
    * routed signals
    * Fixed up silkscreens and added mousebites
    * Fixed up silkscreens and added mousebites
    * 3d models of encoder and display
    * cleaned up layout
    * cleaned up layout
    * Rename project
    * Remove extraneous files
    * As-ordered version
    * As-ordered version
    * version 1.5 updates
    * Updated to Kicad 6.0
    * Genereated Gerber Files
    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
    [PCA9554APW_118.step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]
2022-03-14 Added Schematic PDF file and Step 3D model (#726)
    * Add PDF of schematic and step file
    * ignore kicad backups
    * Moved PDF files to the RASCSI.wiki repo
    [rascsi_2p5.step]
2022-12-12 rascsi 2p6 and daisy chain rebrand
    [Connectors.kicad_sch, USB_Conn.kicad_sch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]
2023-01-21 update silkscreen to say piscsi and regenerate prod files
    [Connectors.kicad_sch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]
2023-01-21 add prod files
    [BOM-piscsi_2p6.csv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]
2023-01-22 Revert back to original version of rascsi 2.6 board.
    This reverts commit 2b424468fa236e169660193e1614c490b0ff0ed6.
    [BOM-piscsi_2p6.csv, Connectors.kicad_sch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]
2023-02-25 Piscsi 2p7 (#3)
    [BOM-piscsi.csv, Connectors.kicad_sch, USB_Conn.kicad_sch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]
2023-02-25 Update 2.6 board with new branding silkscreen. No functional updates (#2)
    [BOM-piscsi.csv, Connectors.kicad_sch, USB_Conn.kicad_sch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]
2023-02-25 updated control board and updated text on daisy chain board (#4)
    [PCA9554APW_118.step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]
2023-02-27 PiSCSI Zero 1.1 files (#5)
    [Connectors.sch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]
2023-03-15 Piscsi 2p7 and daisy chain v2 (#6)
    * rebrand
    * rebrand
    * ignore macos temp file
    * rename to 2.7
    * as ordered 2.7
    * rebranded to piscsi
    ---------
    [daisy_chain_board-B_Mask.gbs, daisy_chain_board-B_Paste.gbp, daisy_chain_board-B_Silkscreen.gbo, daisy_chain_board-Bottom.gbl, daisy_chain_board-Edge_Cuts.gm1, daisy_chain_board-F_Mask.gts, daisy_chain_board-F_Paste.gtp, daisy_chain_board-F_Silkscreen.gto]
2023-05-01 regenerate schematic and convert to KiCad 7
    [Connectors.kicad_sch, USB_Conn.kicad_sch, piscsi.kicad_sch]
2023-05-01 Updated to Kicad 7 & regenerate schematic
    [rascsi_zero.kicad_sch]
2024-04-04 regenerated piscsi zero prod files
    [rascsi_zero-CuBottom.gbr, rascsi_zero-CuTop.gbr, rascsi_zero-EdgeCuts.gbr, rascsi_zero-MaskBottom.gbr, rascsi_zero-MaskTop.gbr, rascsi_zero-NPTH.drl, rascsi_zero-PTH.drl, rascsi_zero-PasteBottom.gbr]
