PiSCSI/piscsi-hw/(notices)

Notices in the files:
piscsi_zero_1p1/rascsi_zero.kicad_pcb:
Copyright 2022 akuker
piscsi_2p7/piscsi.kicad_pcb:
Copyright 2023 akuker
